kennethlimcp/rob-vacuum/Handwritten notes/photon-pin-table.jpg

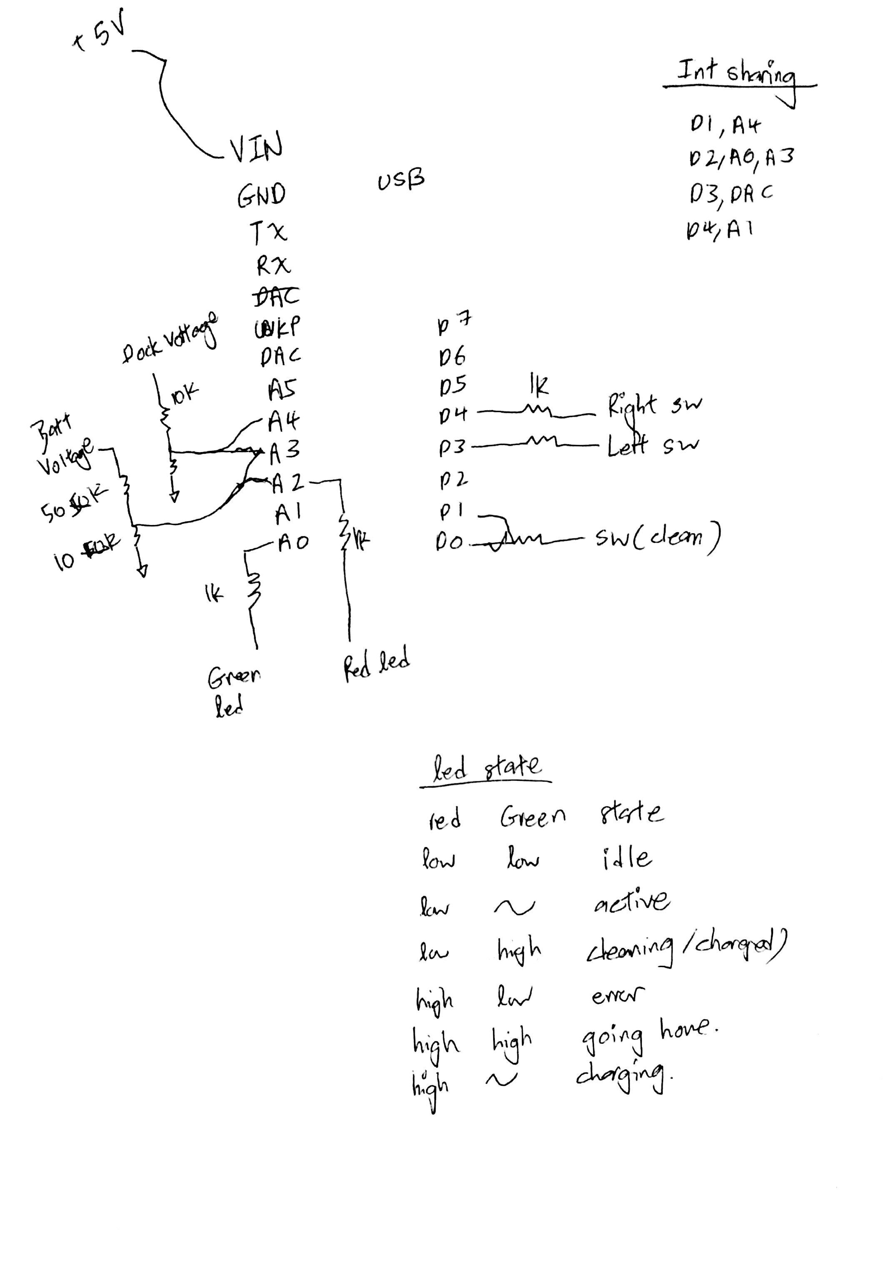
Handwritten notes/photon-pin-table.jpg
