kennethlimcp/rob-vacuum/IR waveform/1.png

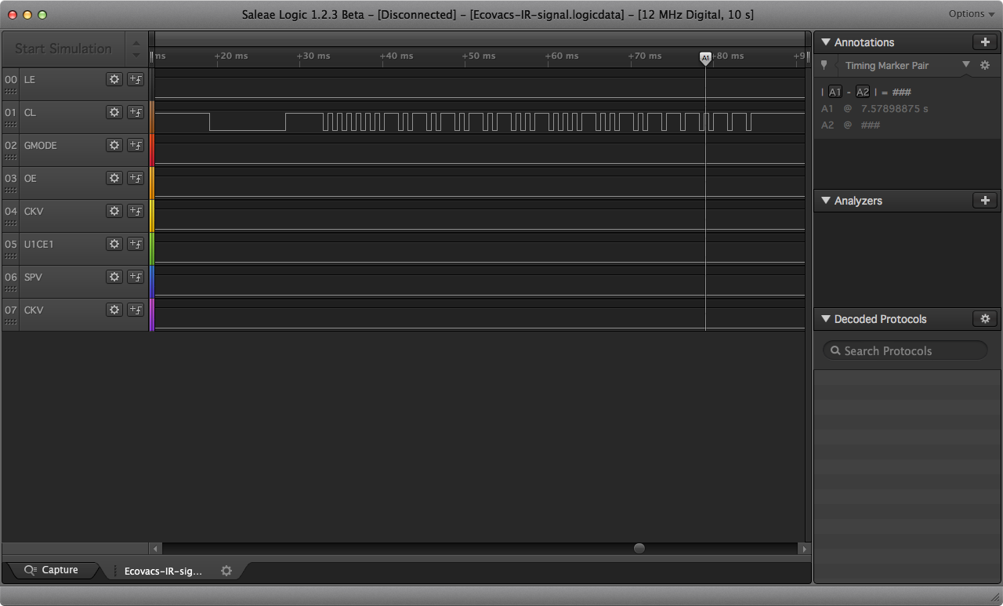
IR waveform/1.png
