kennethlimcp/rob-vacuum/IR waveform/2.png

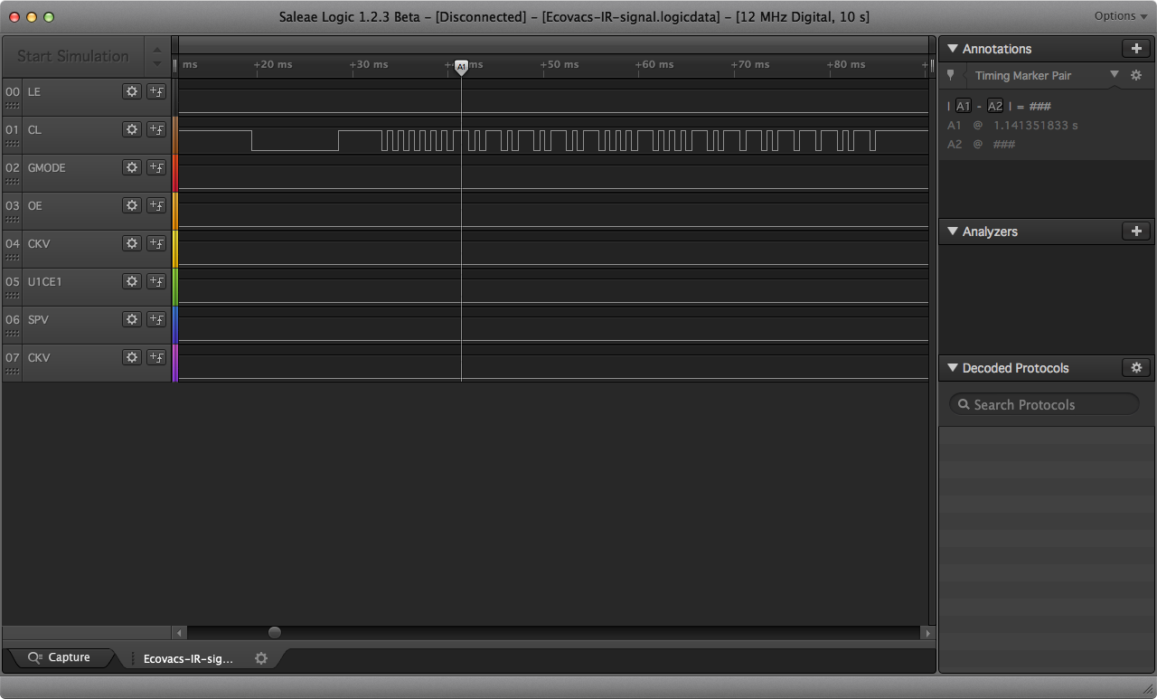
IR waveform/2.png
