kennethlimcp/rob-vacuum/Photos/Hack 23Jul16/IMG_20160723_205716.jpg

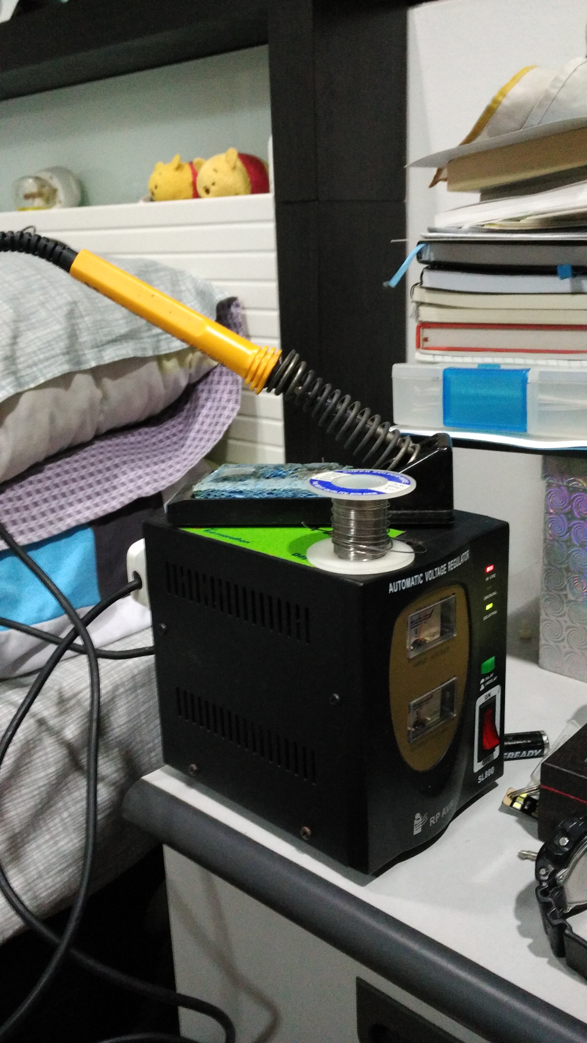
Photos/Hack 23Jul16/IMG_20160723_205716.jpg
