kennethlimcp/rob-vacuum/Photos/Hack 23Jul16/IMG_20160723_225400.jpg

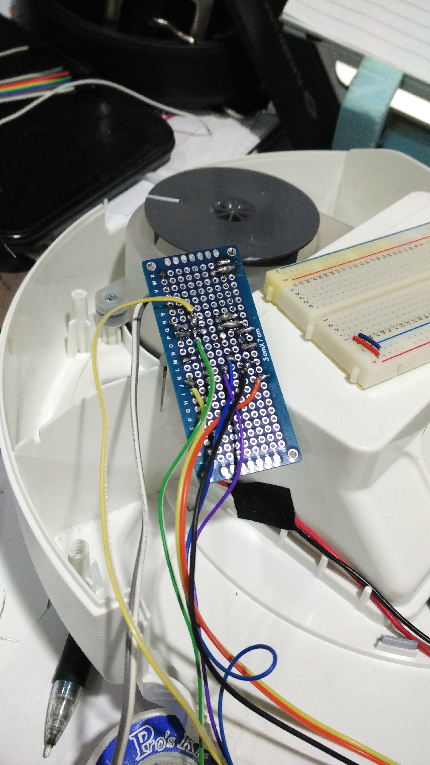
Photos/Hack 23Jul16/IMG_20160723_225400.jpg
