kennethlimcp/rob-vacuum/Photos/Hack 23Jul16/IMG_20160724_121341.jpg

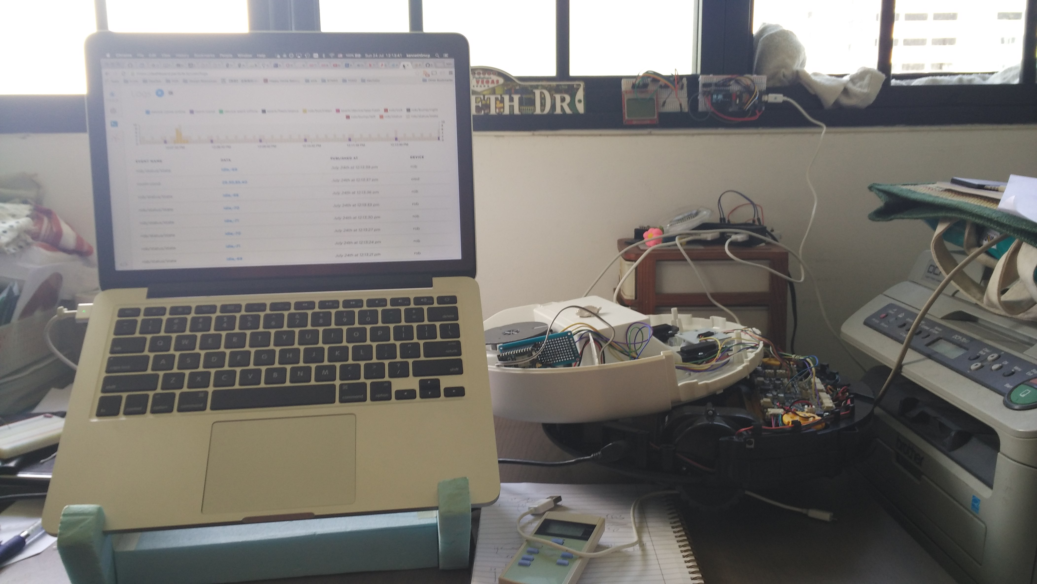
Photos/Hack 23Jul16/IMG_20160724_121341.jpg
