kennethlimcp/rob-vacuum/Photos/Hack 23Jul16/Screenshot/Screen Shot 2016-07-24 at 10.47.29.png

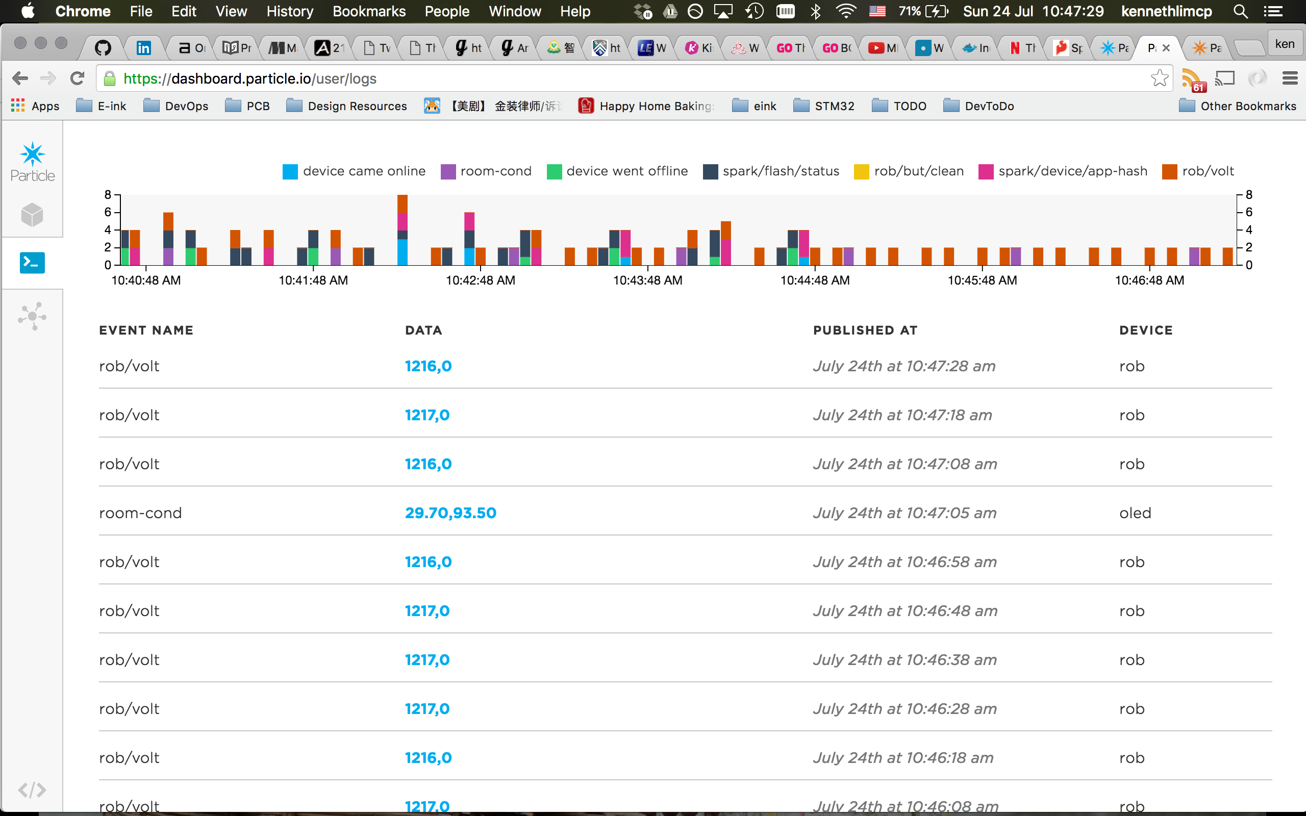
Photos/Hack 23Jul16/Screenshot/Screen Shot 2016-07-24 at 10.47.29.png
