kennethlimcp/rob-vacuum/Photos/Hack 23Jul16/Screenshot/Screen Shot 2016-07-24 at 12.41.58.png

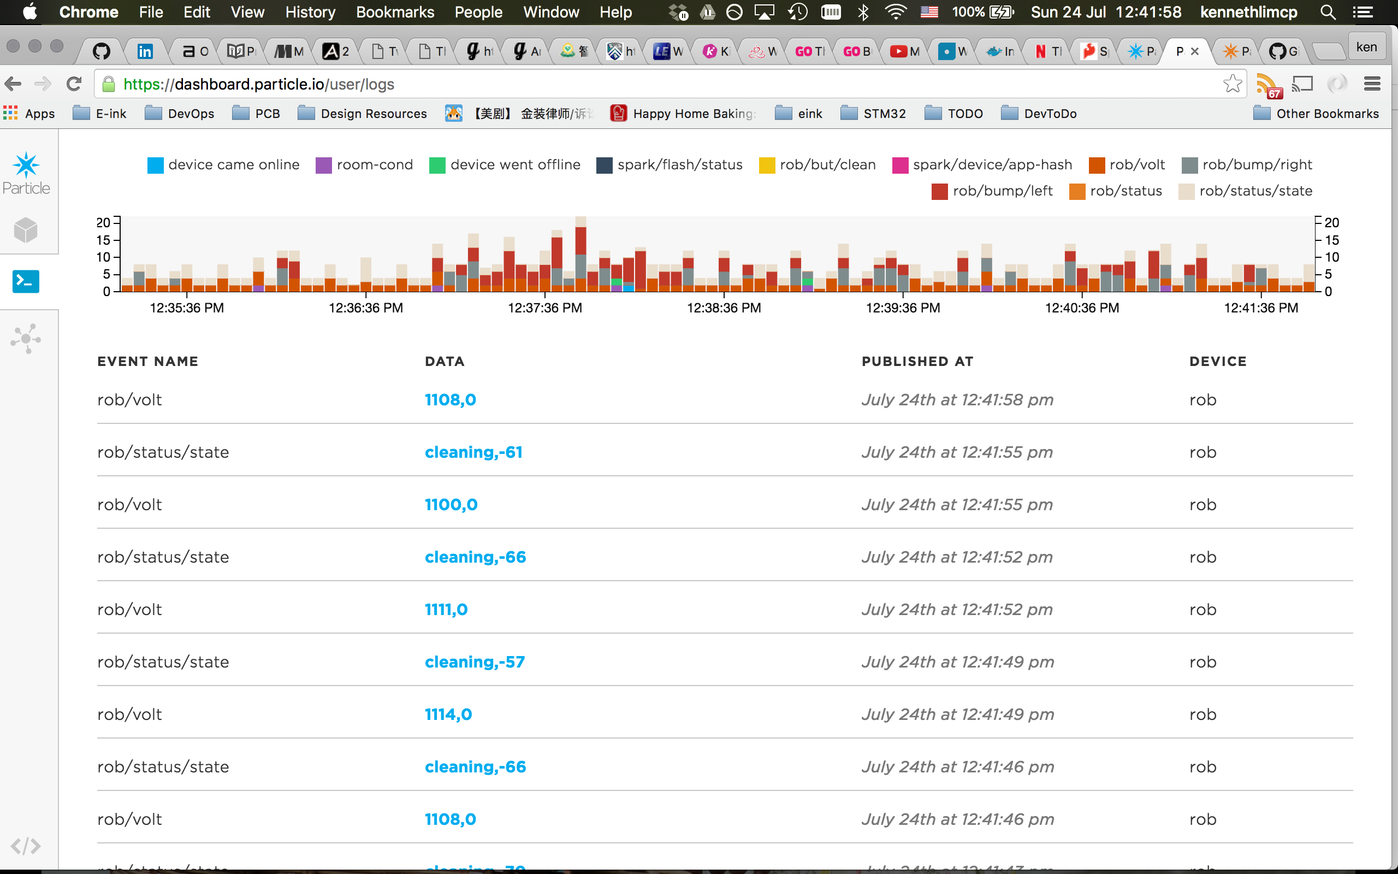
Photos/Hack 23Jul16/Screenshot/Screen Shot 2016-07-24 at 12.41.58.png
