kennethlimcp/rob-vacuum/Photos/Hack 23Jul16/Screenshot/Screen Shot 2016-07-24 at 12.54.20.png

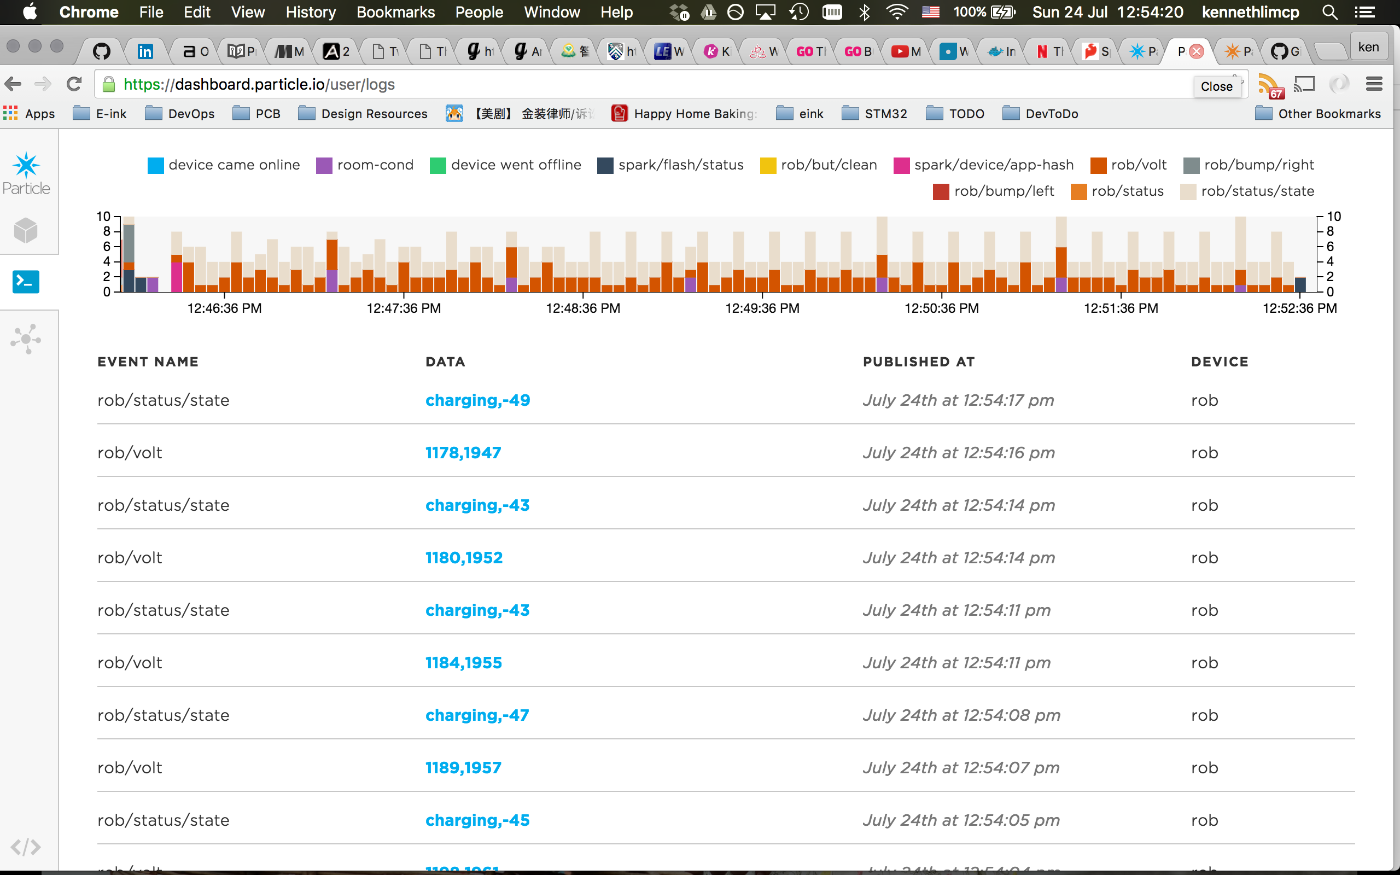
Photos/Hack 23Jul16/Screenshot/Screen Shot 2016-07-24 at 12.54.20.png
