kennethlimcp/rob-vacuum/Handwritten notes/rob-led-wiring.jpg

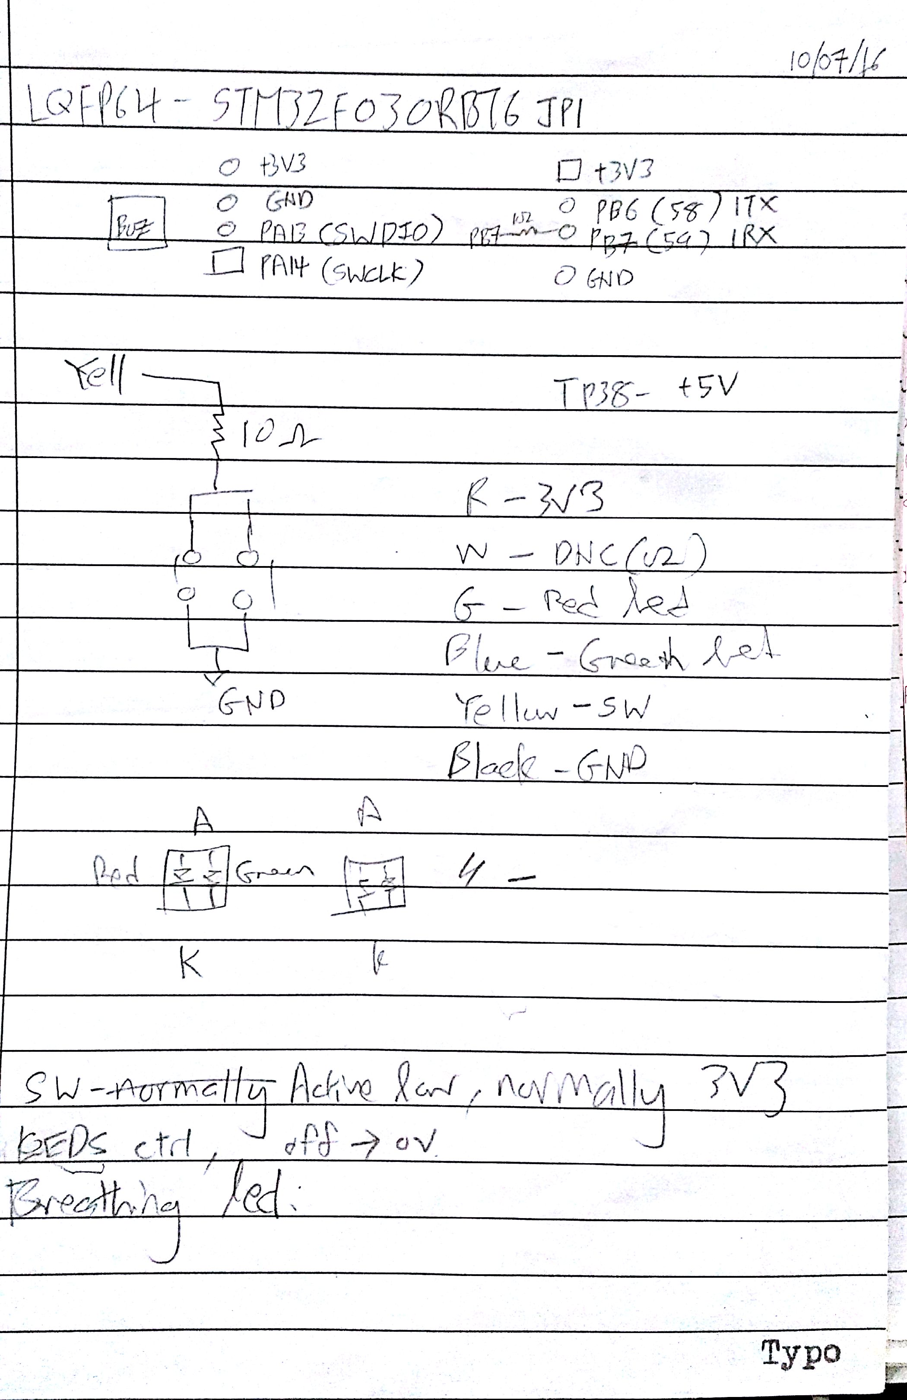
Handwritten notes/rob-led-wiring.jpg
