kennethlimcp/rob-vacuum/Photos/Repair 03Jul16/IMG_20160703_191008.jpg

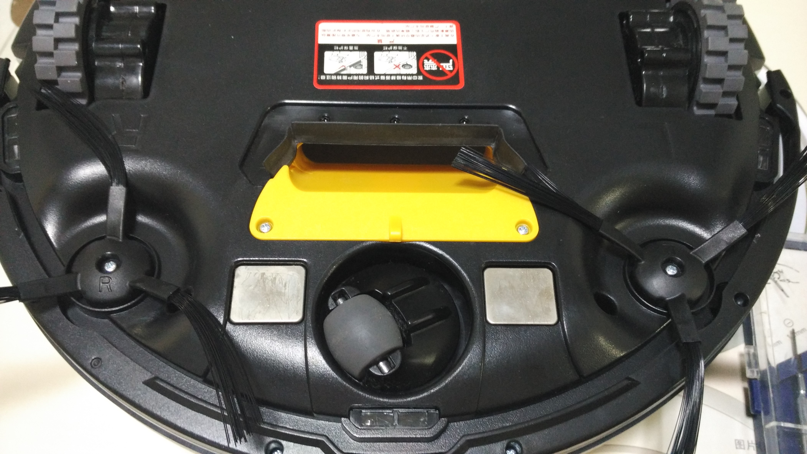
Photos/Repair 03Jul16/IMG_20160703_191008.jpg
