kennethlimcp/rob-vacuum/Photos/Repair 03Jul16/IMG_20160703_200738.jpg

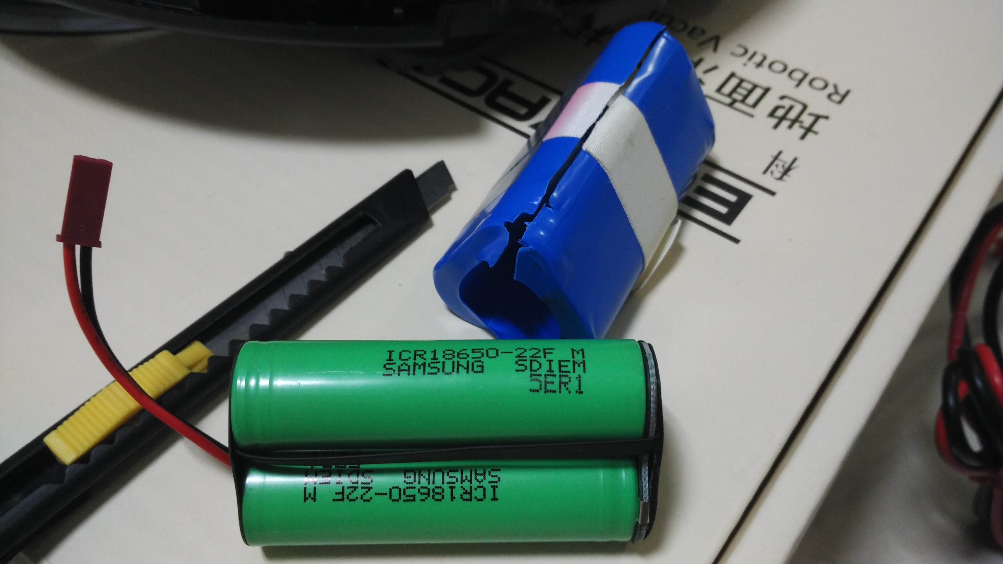
Photos/Repair 03Jul16/IMG_20160703_200738.jpg
