kennethlimcp/rob-vacuum/Photos/Repair 31Jul16/IMG_20160731_195715.jpg

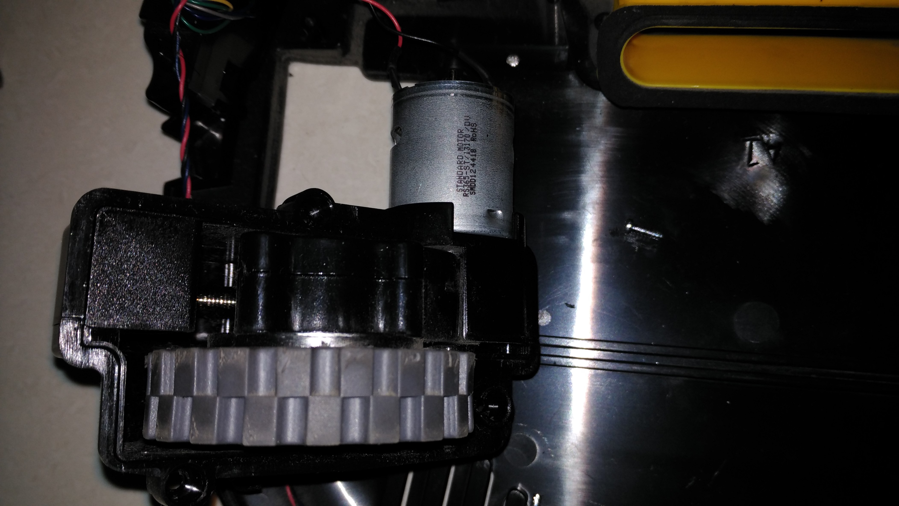
Photos/Repair 31Jul16/IMG_20160731_195715.jpg
