kennethlimcp/rob-vacuum/Photos/Repair 31Jul16/IMG_20160801_205008.jpg

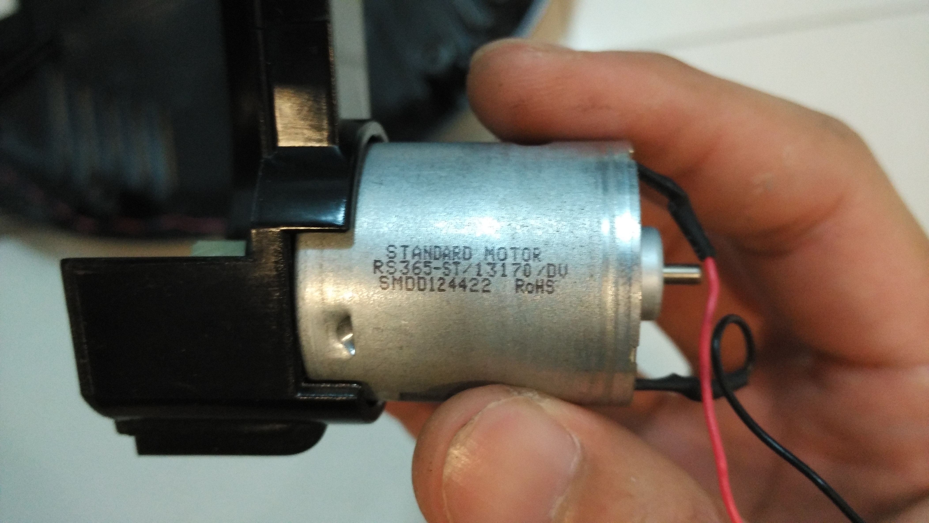
Photos/Repair 31Jul16/IMG_20160801_205008.jpg
