kennethlimcp/rob-vacuum/(commit log)

2016-07-30 fix: reset idleCounter after Sleep
    [rob-monitor.ino]
2016-10-30 update: IR functionality!
    With the addition of an IR LED hooked up to the TX pin, the Photon is now able to tranmit IR signals, mimicing the use of a remote!
2016-10-30 update: README.md
    Addiing of IR Led on 07 Oct 16
